Marzac/zekit/Schematics/zekit.v3.4-02.09.21-3d.png

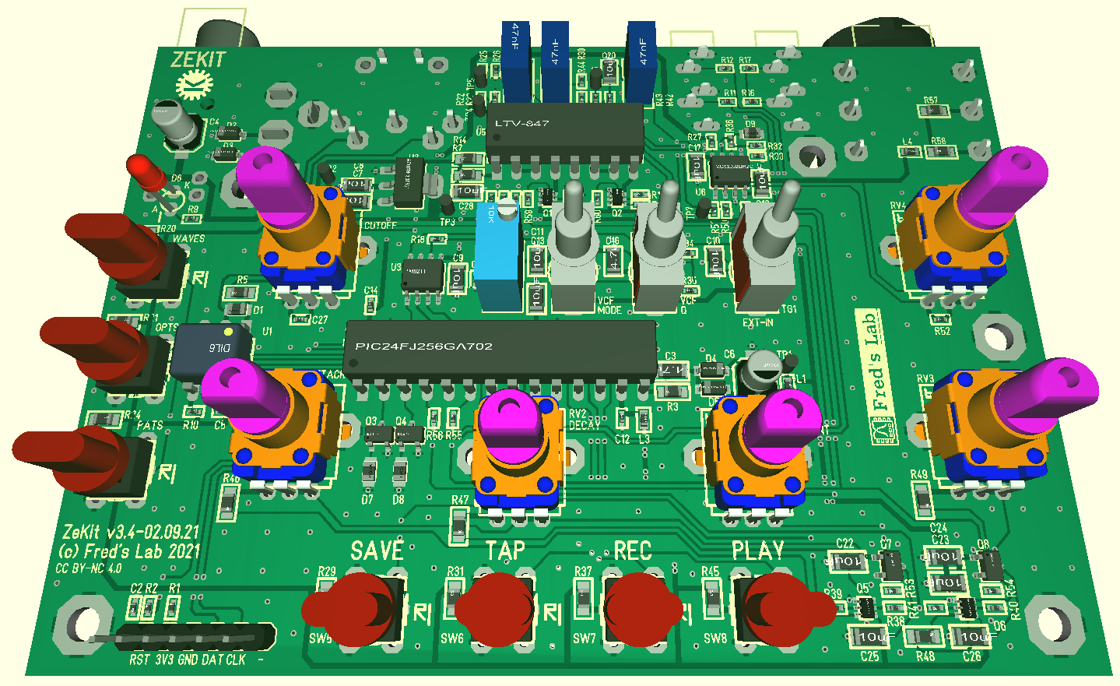
Schematics/zekit.v3.4-02.09.21-3d.png
