Marzac/zekit/Instructions/assets/signature.jpg

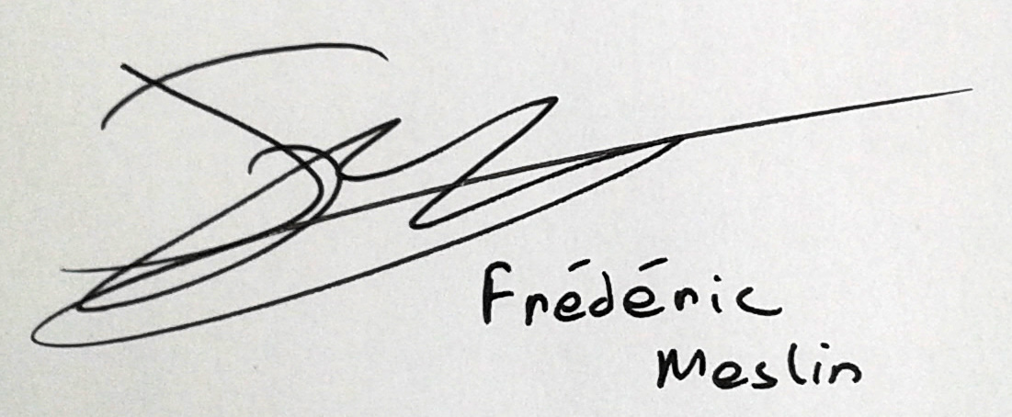
Instructions/assets/signature.jpg
