Marzac/zekit/Instructions/assets/soldering-heatup.png

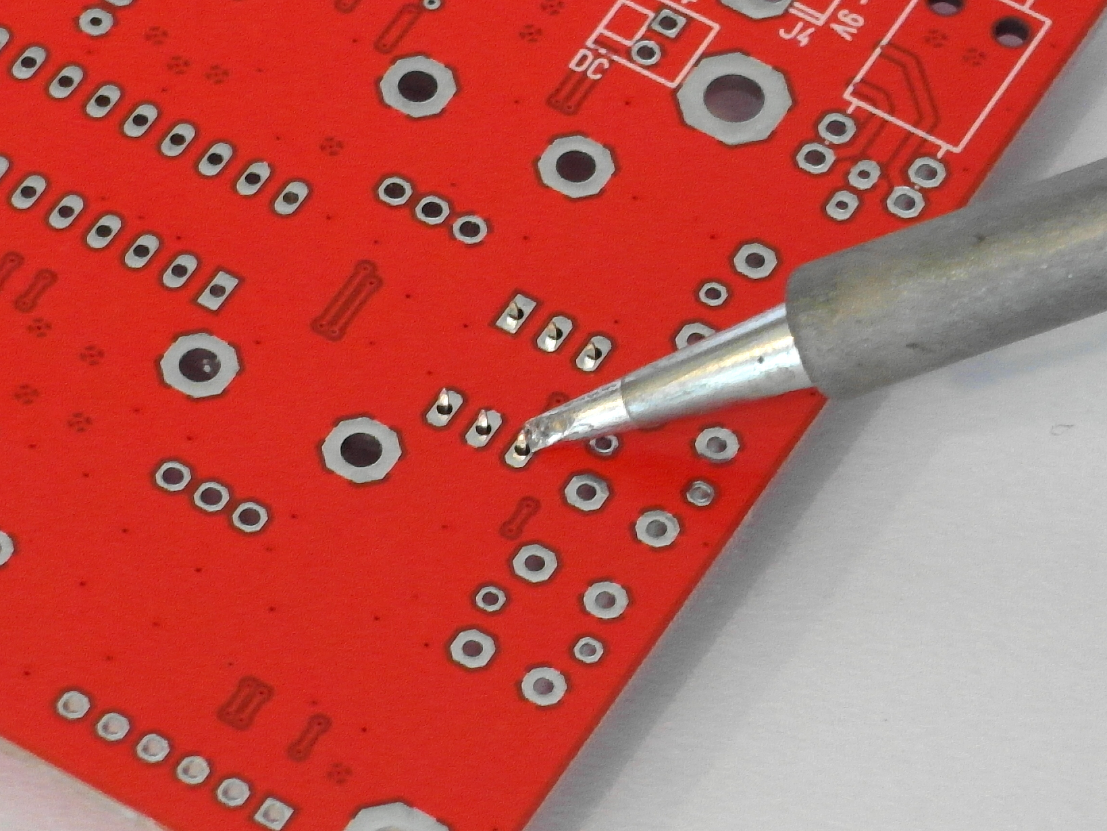
Instructions/assets/soldering-heatup.png
