Marzac/zekit/Instructions/assets/soldering-remove.png

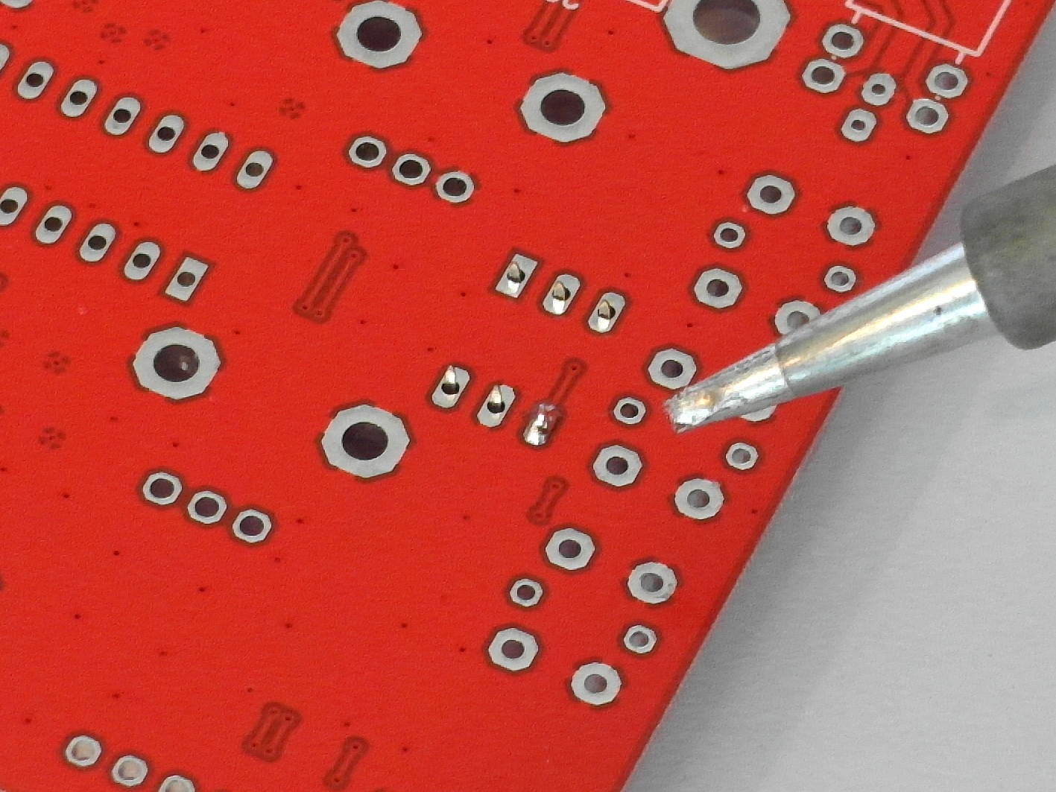
Instructions/assets/soldering-remove.png
