Marzac/zekit/Instructions/assets/soldering-solder.png

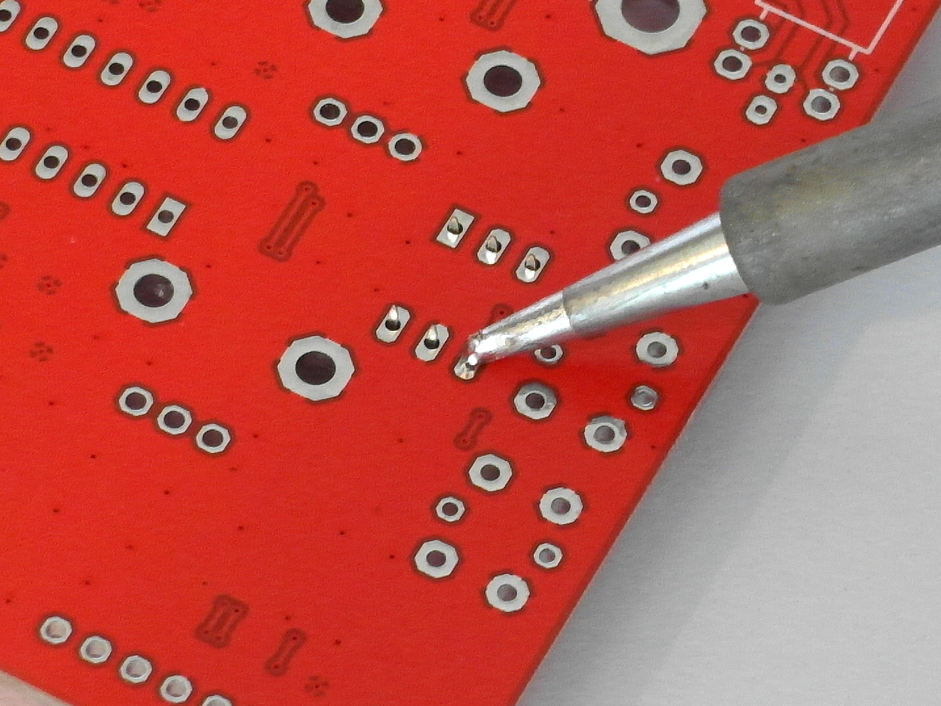
Instructions/assets/soldering-solder.png
