Marzac/zekit/Instructions/assets/soldering-tape.png

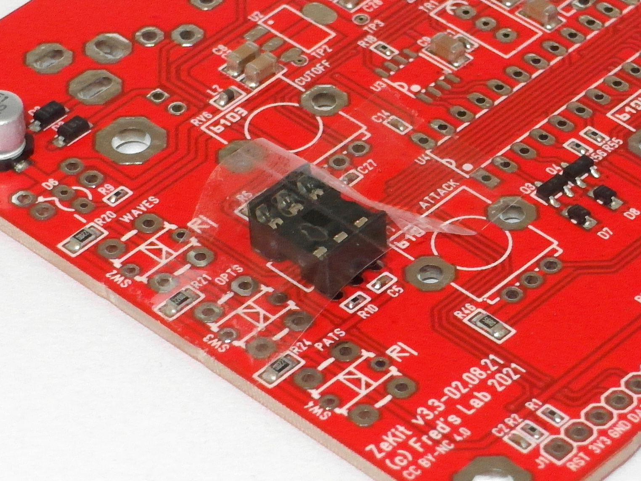
Instructions/assets/soldering-tape.png
