Marzac/zekit/Instructions/assets/soldering-wire.png

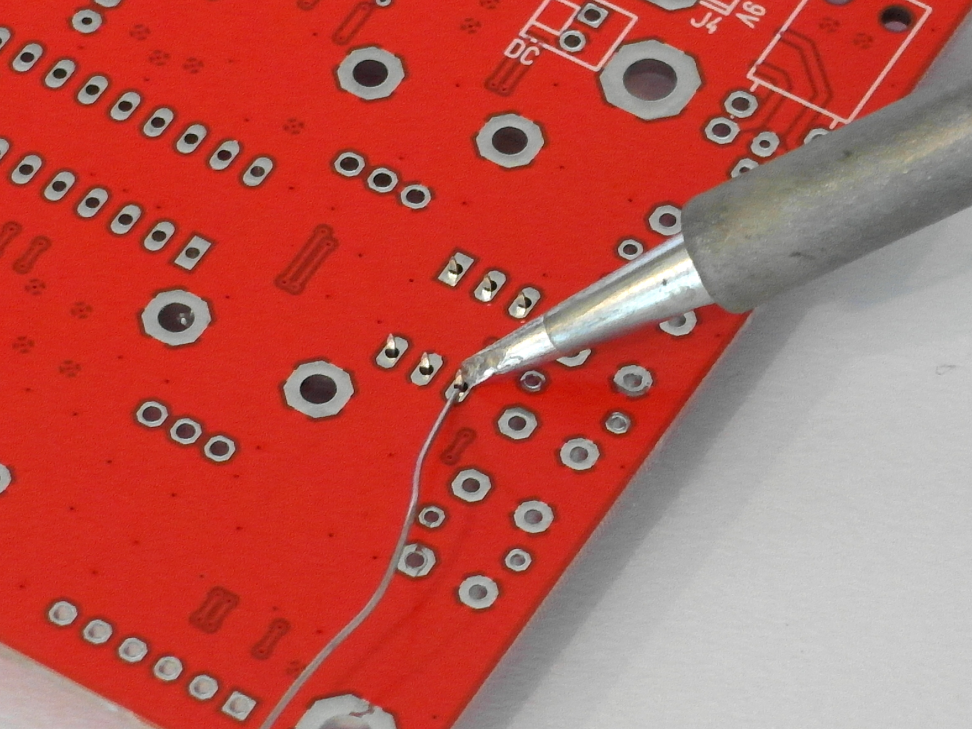
Instructions/assets/soldering-wire.png
