Marzac/zekit/Instructions/assets/weee.png

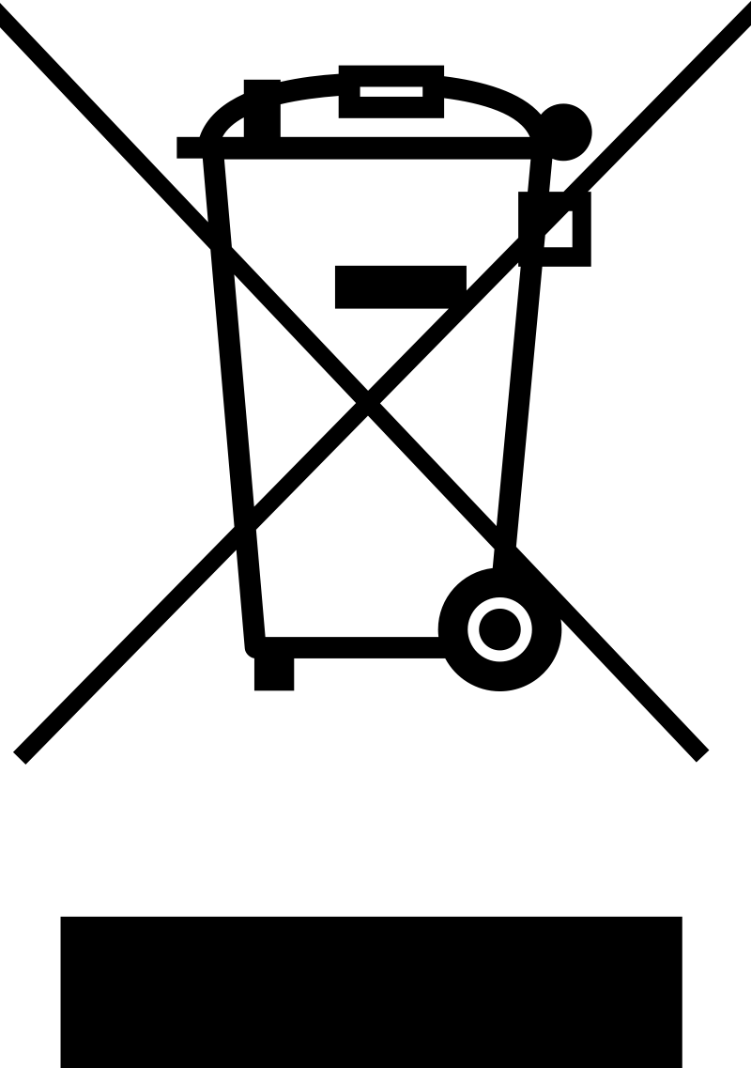
Instructions/assets/weee.png
