Marzac/zekit/Instructions/assets/zekit-assembled-back1.jpg

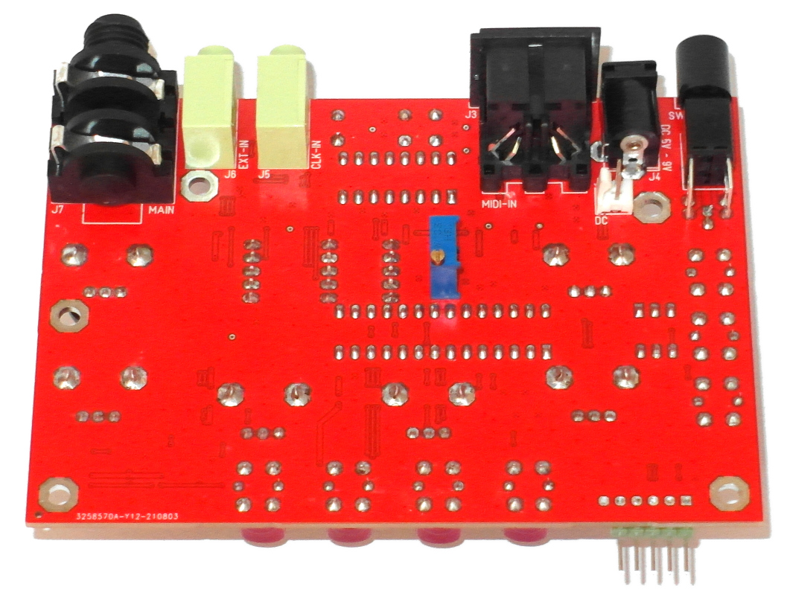
Instructions/assets/zekit-assembled-back1.jpg
