Marzac/zekit/Instructions/assets/zekit-assembled-back2.jpg

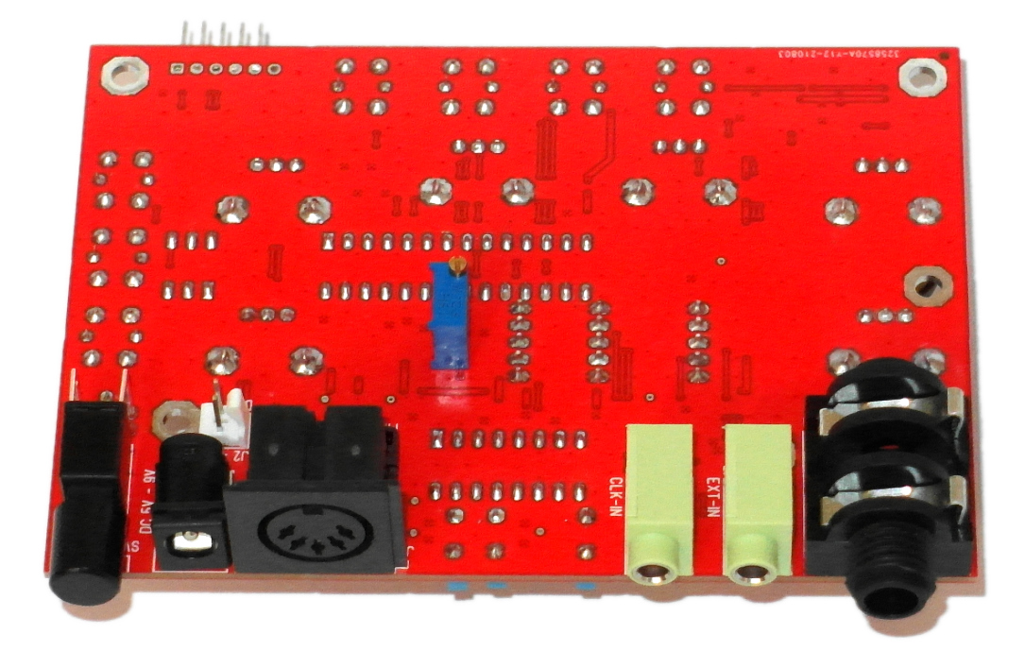
Instructions/assets/zekit-assembled-back2.jpg
