Marzac/zekit/Instructions/assets/zekit-dcjack-resized.jpg

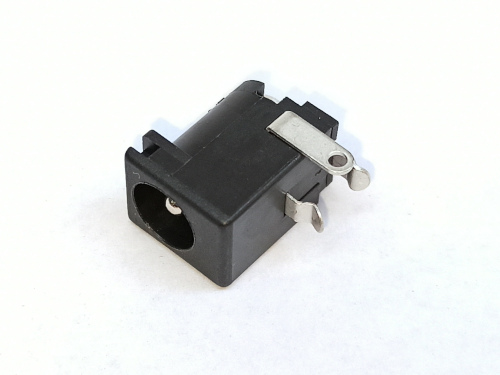
Instructions/assets/zekit-dcjack-resized.jpg
