Marzac/zekit/Instructions/assets/zekit-din-resized.jpg

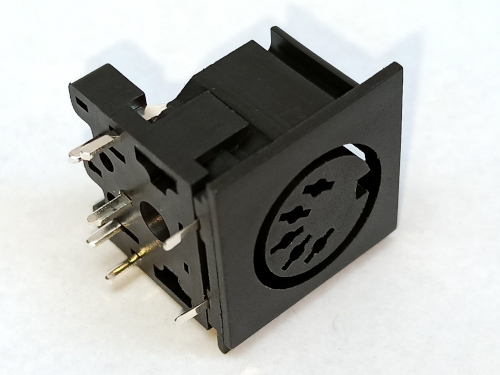
Instructions/assets/zekit-din-resized.jpg
