Marzac/zekit/Instructions/assets/zekit-filmcaps-resized.jpg

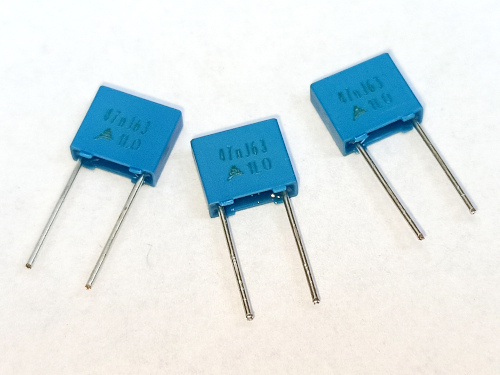
Instructions/assets/zekit-filmcaps-resized.jpg
