Marzac/zekit/Instructions/assets/zekit-jack1-resized.jpg

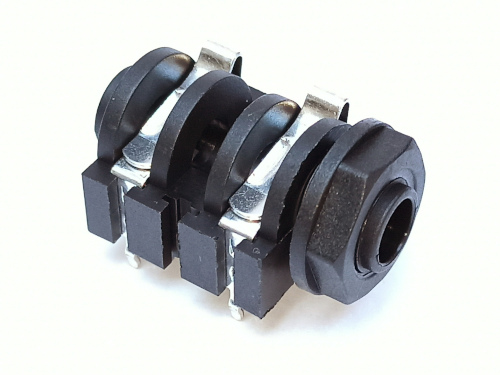
Instructions/assets/zekit-jack1-resized.jpg
