Marzac/zekit/Instructions/assets/zekit-jack2-resized.jpg

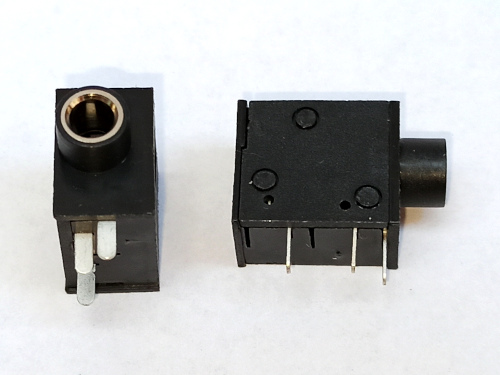
Instructions/assets/zekit-jack2-resized.jpg
