Marzac/zekit/Instructions/assets/zekit-knobs-resized.jpg

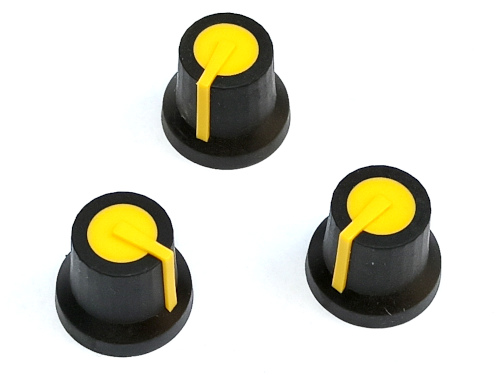
Instructions/assets/zekit-knobs-resized.jpg
