Marzac/zekit/Instructions/assets/zekit-panel.jpg

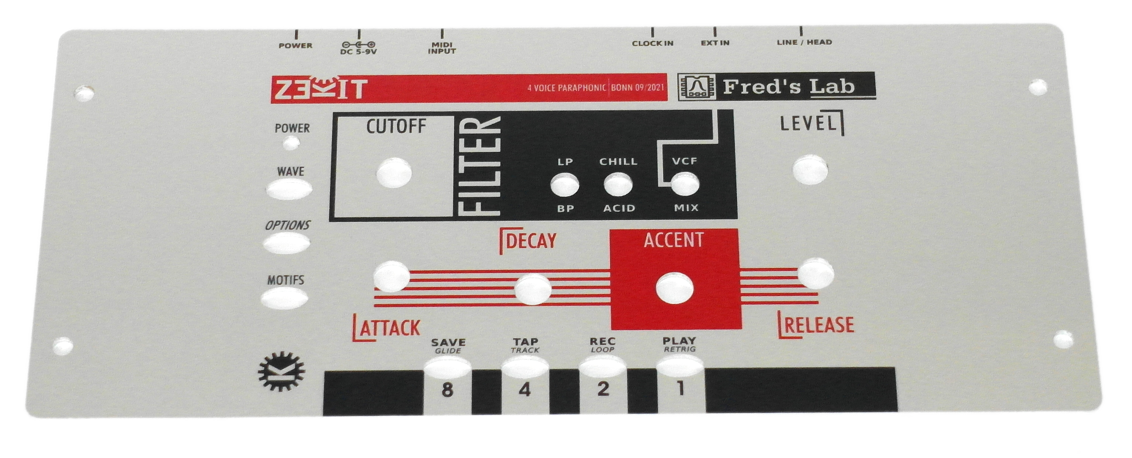
Instructions/assets/zekit-panel.jpg
