Marzac/zekit/Instructions/assets/zekit-pots1-resized.jpg

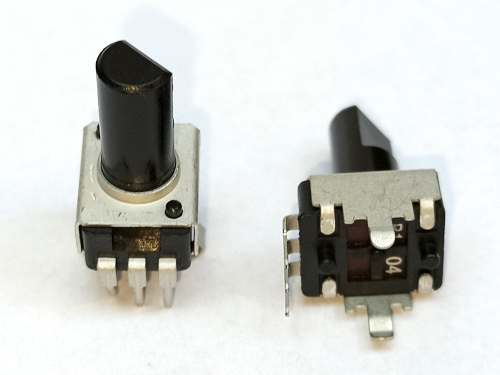
Instructions/assets/zekit-pots1-resized.jpg
