Marzac/zekit/Instructions/assets/zekit-pots2-resized.jpg

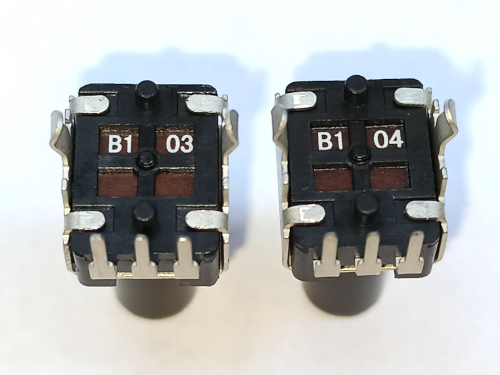
Instructions/assets/zekit-pots2-resized.jpg
