Marzac/zekit/Instructions/assets/zekit-powerswitch-resized.jpg

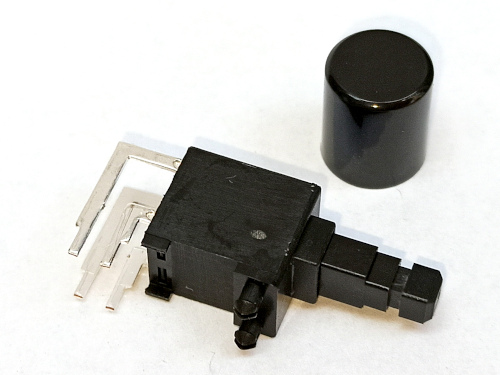
Instructions/assets/zekit-powerswitch-resized.jpg
