Marzac/zekit/Instructions/assets/zekit-sockets-resized.jpg

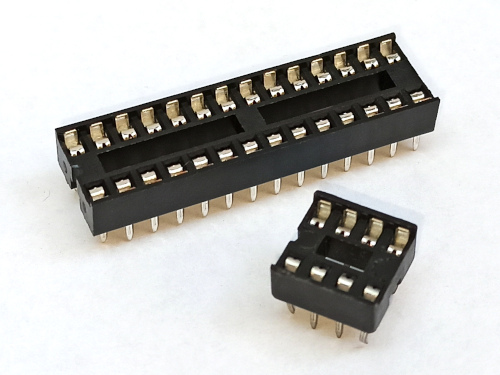
Instructions/assets/zekit-sockets-resized.jpg
