Marzac/zekit/Instructions/assets/zekit-tacts-resized.jpg

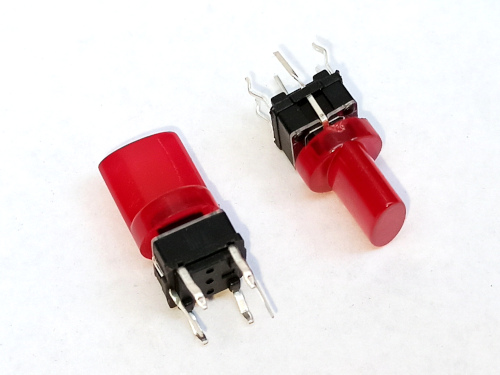
Instructions/assets/zekit-tacts-resized.jpg
