Marzac/zekit/Schematics/zekit.v3.4-02.09.21-schematics.pdf

# Schematics and tech docs LP/BP

100 R26

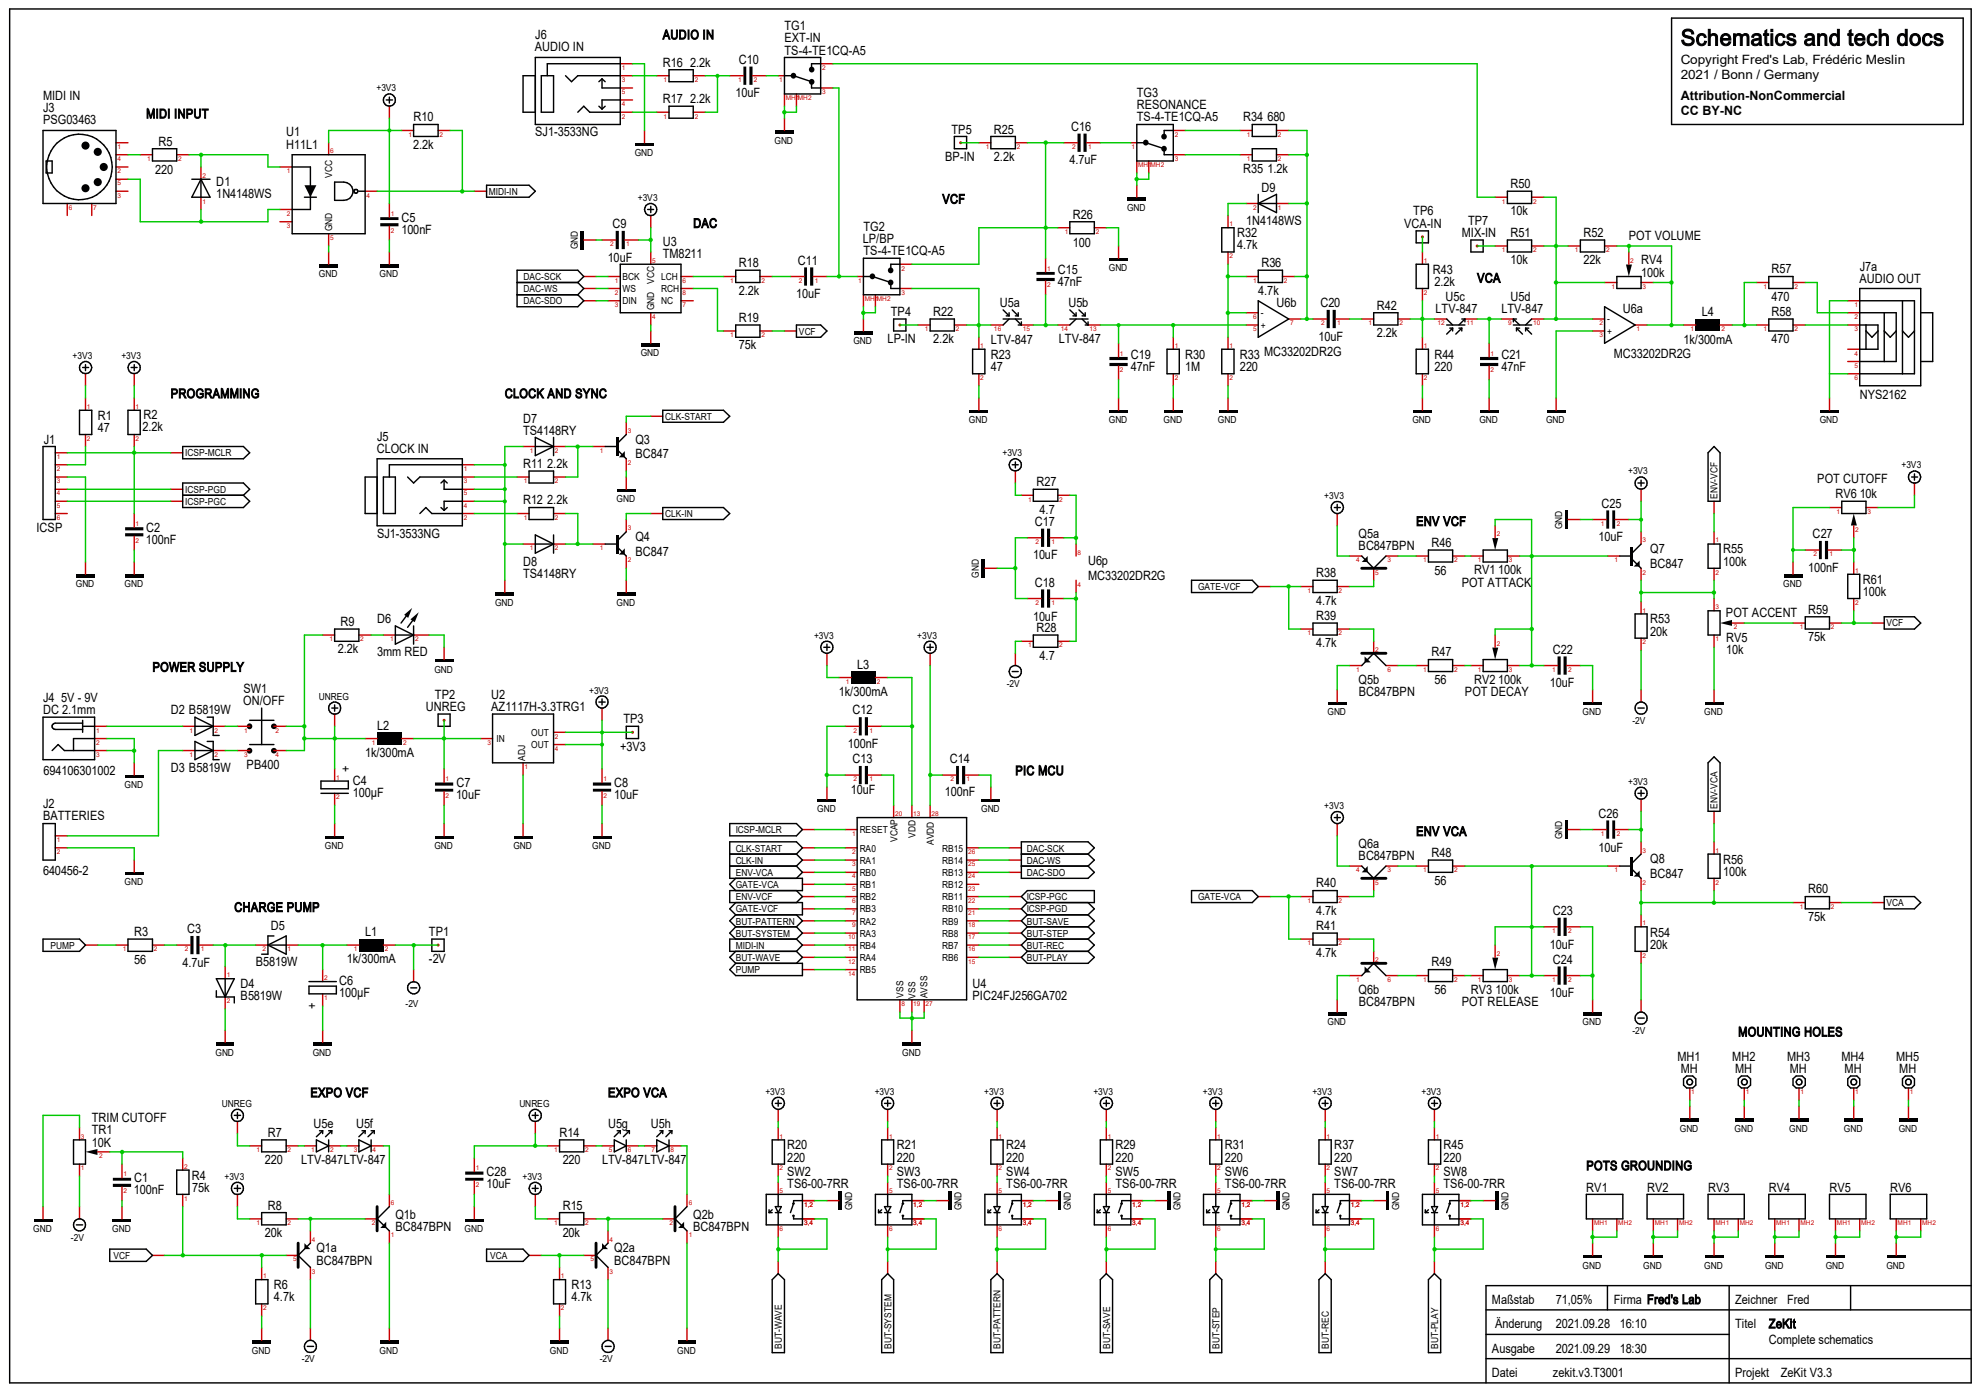
[picture p78: page 1]

Copyright Fred's Lab, Frédéric Meslin
Attribution-NonCommercial 2021 / Bonn / Germany

DAC-WS DAC-SCK

1 | ICSP-MCLR

ENV-VCF BUT-PATTERN

BUT-SYSTEM
BUT-PLAY MIDI-IN
BUT-WAVE
PUMP

Änderung 2021.09.28 16:10 | Zeichner Datei Maßstab Projekt Titel Firma ZeKit ZeKit V3.3 Fred's Lab Fred Complete schematics
