Marzac/zekit/Schematics/zekit.v3.4-02.09.21-bot.pdf

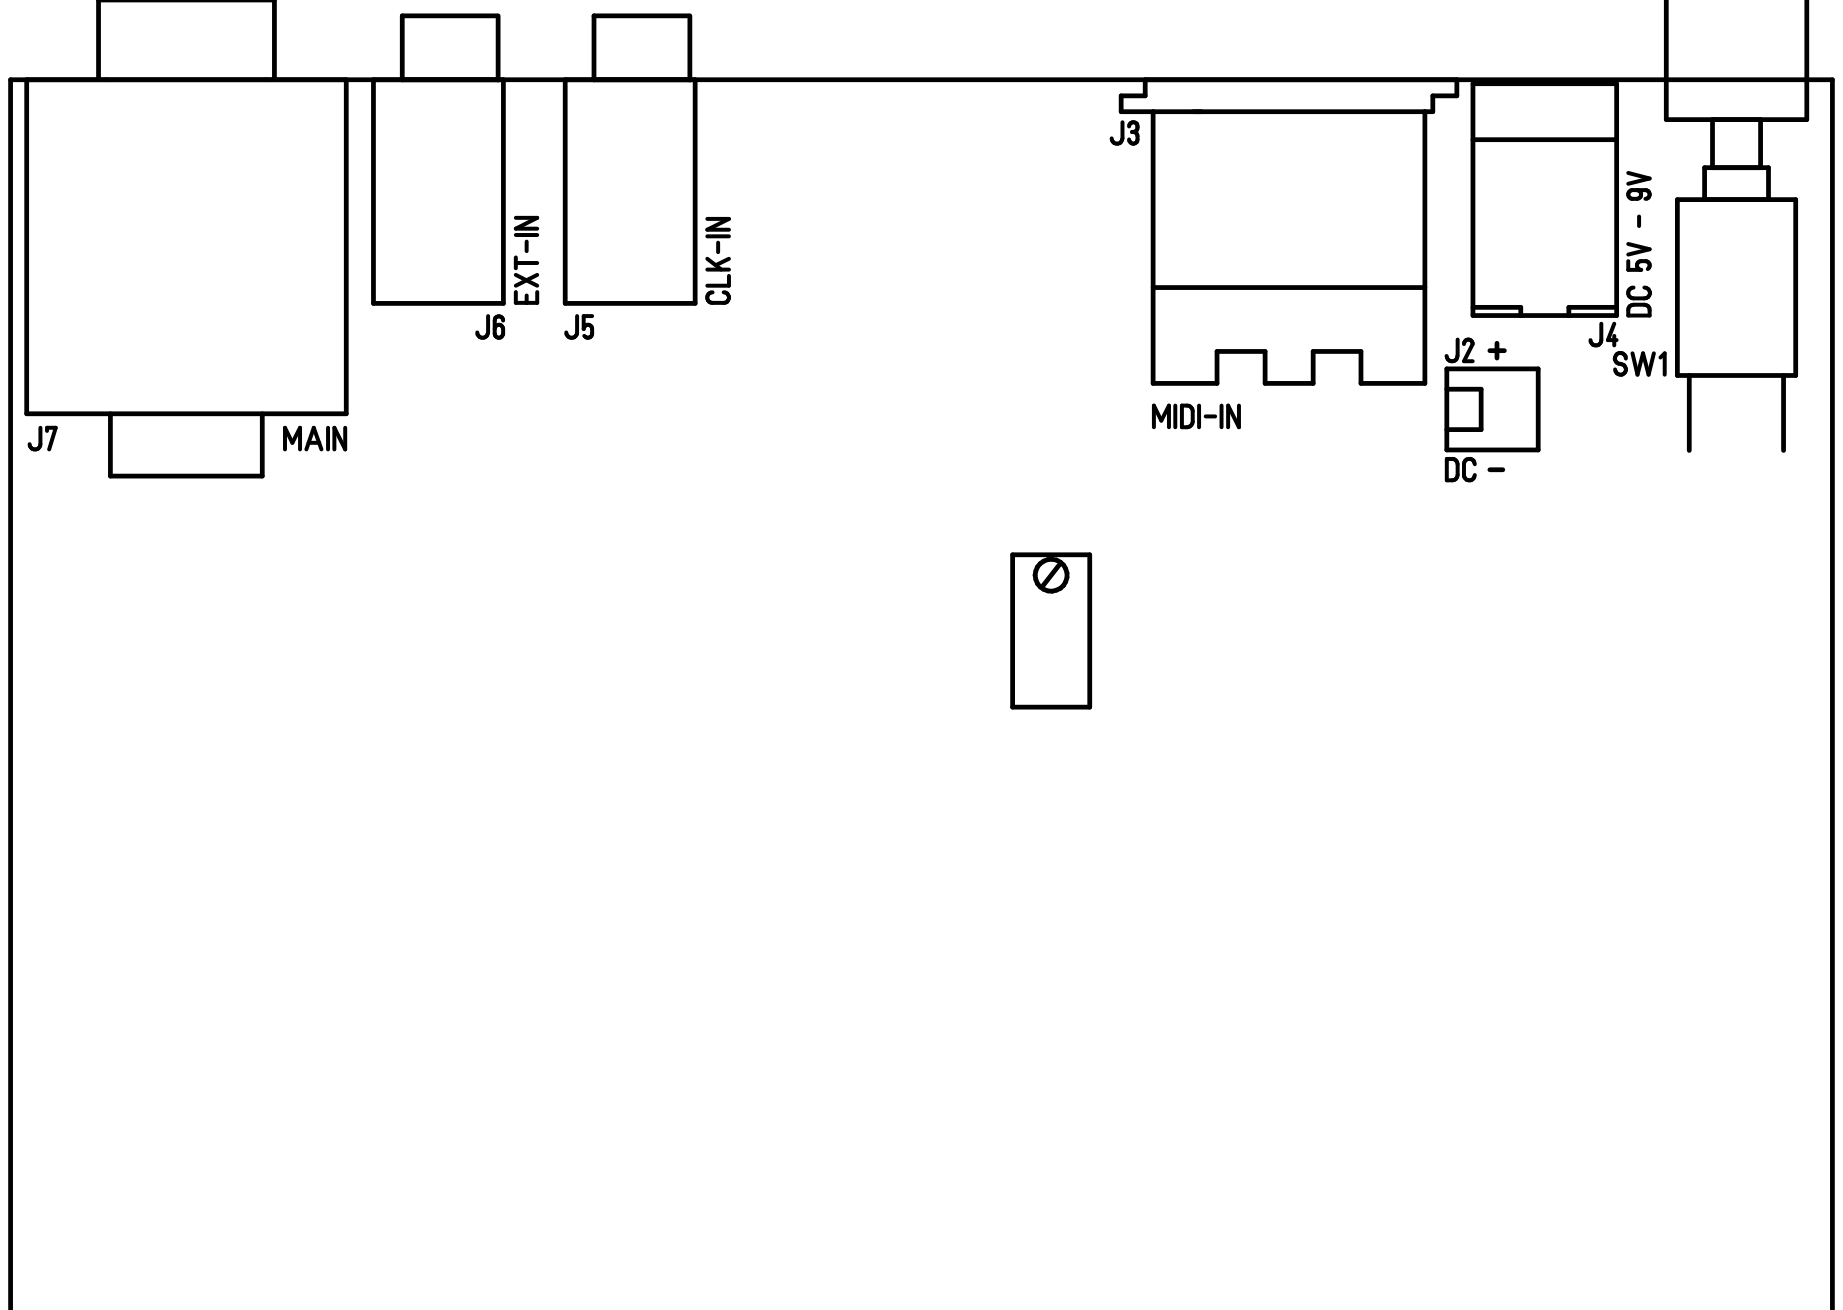
[picture p79: page 1]
