Marzac/zekit/Schematics/zekit.v3.4-02.09.21-top.pdf

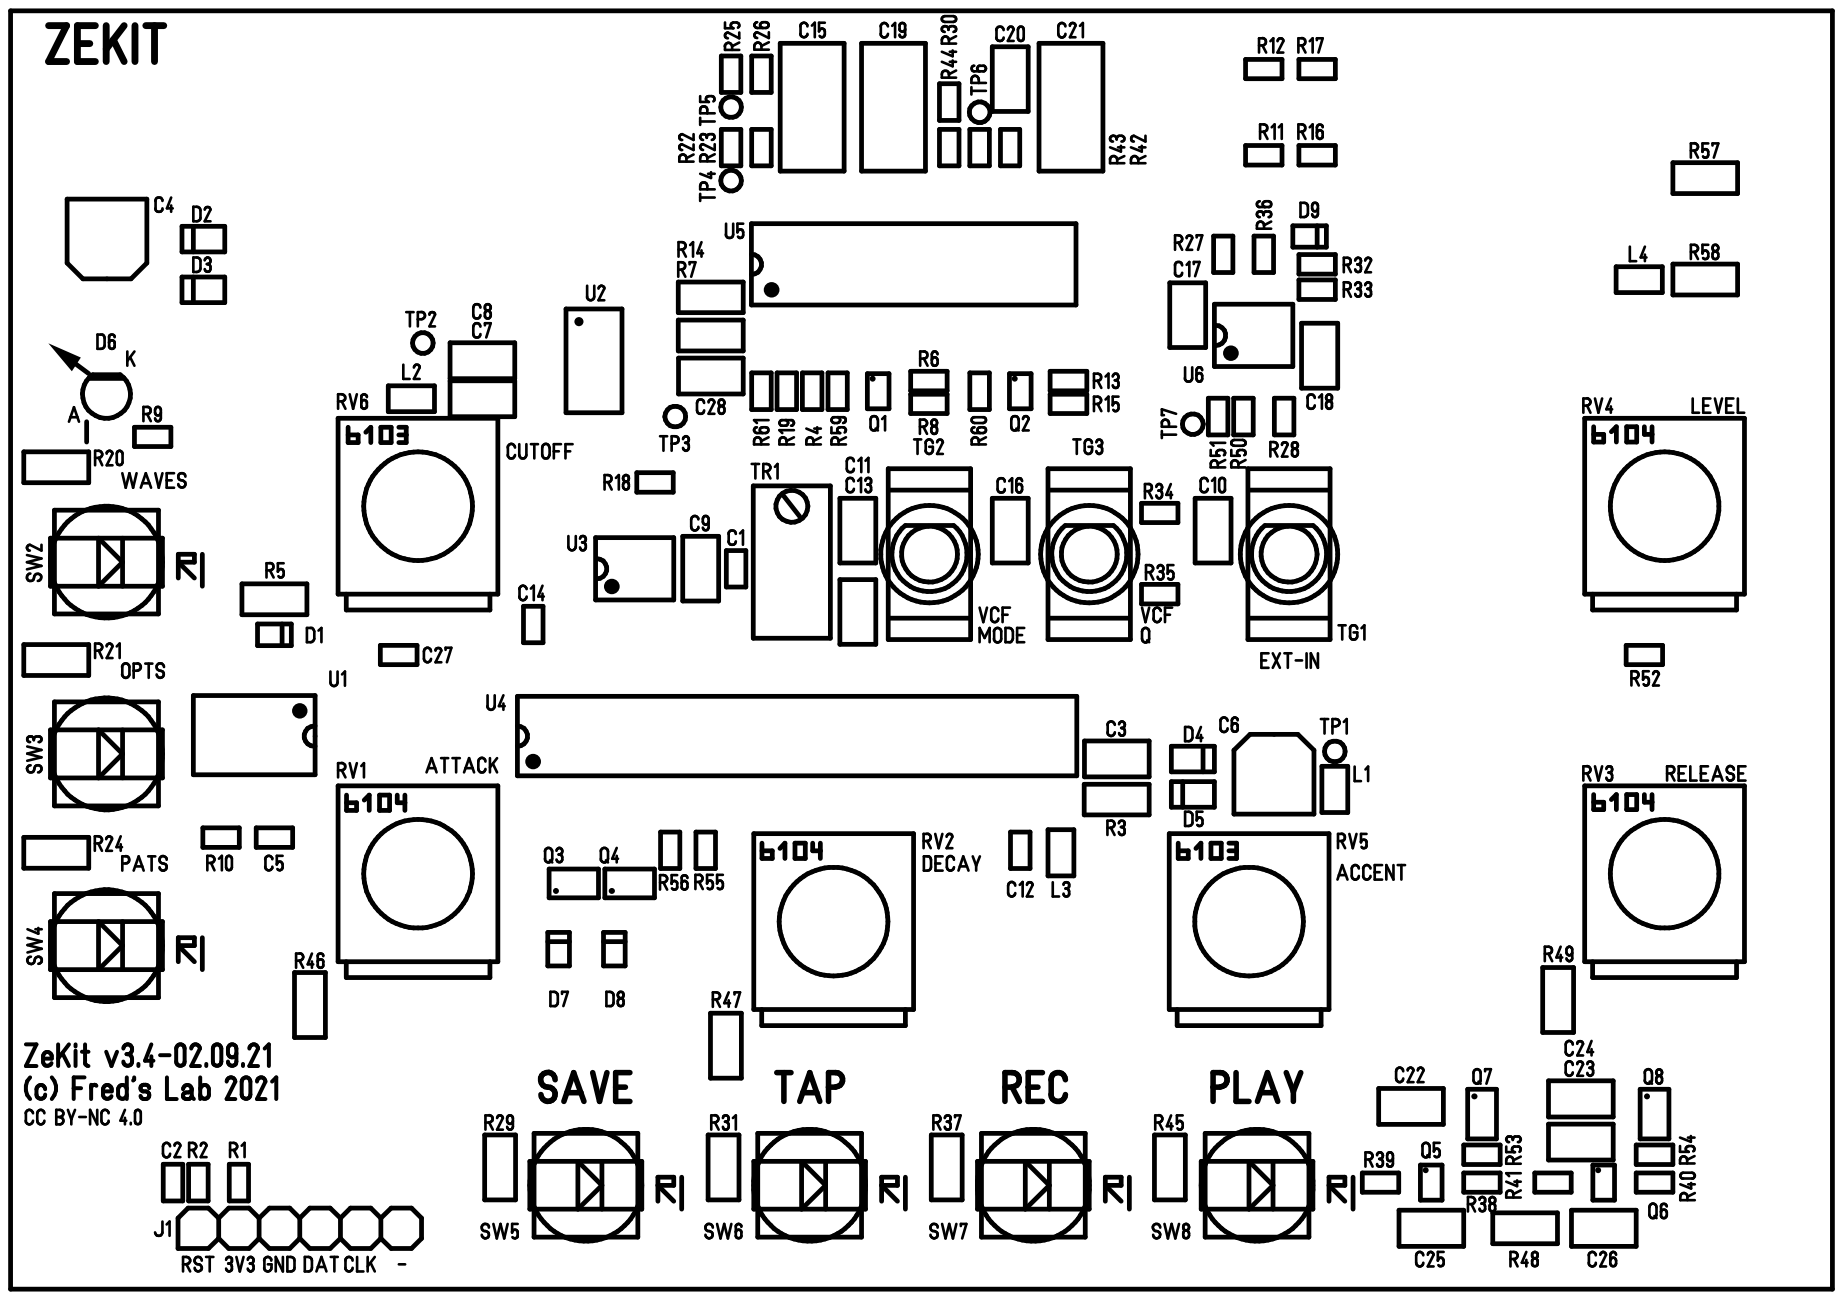
[picture p80: page 1]
