Marzac/zekit/Firmware/main.c

/**
 * ZeKit Firmware v2.0
 * Copyright (C) 2021/2022 - Frédéric Meslin
 * Contact: fred@fredslab.net

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
 * You should have received a copy of the GNU General Public License
 * along with this program.	 If not, see <https://www.gnu.org/licenses/>.
 */
/******************************************************************************/

#include "setup.h"
#include "midi.h"
#include "mseq.h"
#include "audio.h"
#include "store.h"
#include "ui.h"

#include "pins.h"
#include "config.h"

#include <xc.h>
#include <stdint.h>

/******************************************************************************/
uint16_t uwTick = 0;

/******************************************************************************/
int main(void)
{
// Peripherals setup
	setup();

// Program initialisation
	midiInit();
	audioInit();
	mseqInit();
	uiInit();

// Program main loop
	while (1) {
		uiUpdate();
		midiUpdate();
		mseqUpdate();
		audioUpdate();
	}

	return 1;
}
