Marzac/zekit/Firmware/waves.c

/**
 * ZeKit Firmware v2.0
 * Copyright (C) 2021/2022 - Frédéric Meslin
 * Contact: fred@fredslab.net

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
 * You should have received a copy of the GNU General Public License
 * along with this program.	 If not, see <https://www.gnu.org/licenses/>.
 */
/******************************************************************************/

#include "waves.h"

#include <stdint.h>

/******************************************************************************/
const Sawer wavesMono[MAX_WAVES][4] = {
{
// Basic sawtooth
	{.phase = 0x00000000, .rate = 128, .shift = 1},
	{.phase = 0x00000000, .rate = 0,   .shift = 16},
	{.phase = 0x00000000, .rate = 0,   .shift = 16},
	{.phase = 0x00000000, .rate = 0,   .shift = 16}},

// Detuned sawtooth
{
	{.phase = 0x00000000, .rate = 127, .shift = 2},
	{.phase = 0x00000000, .rate = 129, .shift = 2},
	{.phase = 0x00000000, .rate = 128, .shift = 2},
	{.phase = 0x00000000, .rate = 0,   .shift = 16}},

// Basic square
{
	{.phase = 0x00000000, .rate = 128, .shift = 2},
	{.phase = 0x80000000, .rate =-128, .shift = 2},
	{.phase = 0x00000000, .rate =	0, .shift = 16},
	{.phase = 0x00000000, .rate =	0, .shift = 16}},

// Detuned square
{
	{.phase = 0x00000000, .rate = 127, .shift = 2},
	{.phase = 0x80000000, .rate =-127, .shift = 2},
	{.phase = 0x00000000, .rate = 129, .shift = 2},
	{.phase = 0x80000000, .rate =-129, .shift = 2}},

// Pulse 25%
{
	{.phase = 0x00000000, .rate = 128, .shift = 1},
	{.phase = 0x40000000, .rate =-128, .shift = 1},
	{.phase = 0x00000000, .rate =	0, .shift = 16},
	{.phase = 0x00000000, .rate =	0, .shift = 16}},

// Double-sawtooth
{
	{.phase = 0x00000000, .rate = 128, .shift = 1},
	{.phase = 0x00000000, .rate = 256, .shift = 2},
	{.phase = 0x00000000, .rate =	0, .shift = 16},
	{.phase = 0x00000000, .rate =	0, .shift = 16}},

// Pulse 10%
{
	{.phase = 0x00000000, .rate = 128, .shift = 1},
	{.phase = 0x18000000, .rate =-128, .shift = 1},
	{.phase = 0x00000000, .rate =	0, .shift = 16},
	{.phase = 0x00000000, .rate =	0, .shift = 16}},

// Ultrasaw
{
	{.phase = 0x00000000, .rate = 127, .shift = 2},
	{.phase = 0x00000000, .rate = 130, .shift = 2},
	{.phase = 0x00000000, .rate = 128, .shift = 2},
	{.phase = 0x80000000, .rate = 256, .shift = 2}},
};

/******************************************************************************/
const Sawer wavesPara[MAX_WAVES][2] = {
{
// Basic sawtooth
	{.phase = 0x00000000, .rate = 128, .shift = 3},
	{.phase = 0x00000000, .rate =	0, .shift = 16}},

// Detuned sawtooth 1
{
	{.phase = 0x00000000, .rate = 255, .shift = 3},
	{.phase = 0x80000000, .rate = 257, .shift = 3}},

// Basic square
{
	{.phase = 0x00000000, .rate = 128, .shift = 4},
	{.phase = 0x80000000, .rate =-128, .shift = 4}},

// Double sawtooth
{
	{.phase = 0x00000000, .rate = 128, .shift = 3},
	{.phase = 0x80000000, .rate = 64,  .shift = 4}},

// Pulse 25%
{
	{.phase = 0x00000000, .rate = 128, .shift = 3},
	{.phase = 0x40000000, .rate =-128, .shift = 3}},

// Detuned sawtooth 2
{
	{.phase = 0x00000000, .rate = 256, .shift = 3},
	{.phase = 0x80000000, .rate = 127, .shift = 4}},

// Pulse 10%
{
	{.phase = 0x00000000, .rate = 128, .shift = 3},
	{.phase = 0x18000000, .rate =-128, .shift = 3}},

// Detuned sawtooth 2
{
	{.phase = 0x00000000, .rate = 129, .shift = 3},
	{.phase = 0x80000000, .rate = 127, .shift = 3}},
};
