Marzac/zekit/(commit log)

2021-05-13 Missing tact switch picture
2021-05-14 Guide: initial setup with common parts and schematics
2021-05-16 Guide: linear regulator
2021-05-16 Guide: linear regulator with less text by Fred
2021-05-16 Guide: charge pump
2021-05-16 Guide: charge pump fix
2021-05-17 Guide: MCU, DAC, tactile switches
2021-05-18 Guide: envelopes, MIDI input, clock input, exponential control circuit
2021-05-18 Guide: exponential control circuit
2021-05-20 Guide: switches, jacks, optocouplers
2021-05-21 Guide: soldering order with remarks
2021-05-31 Guide: trimmers labeling, power switch placement, intro text additions
2021-08-23 New schematics parts
2021-08-23 Integration of schematics in manual
2021-08-23 Correcting VCA schematics
2021-08-27 Complete assembly manual, for review
2021-08-30 Assembly manual corrections
2021-08-30 Version 1.1 of the assembly manual
2021-09-29 Schematics + board diagrams
2021-12-01 Fixing glitch in envelope triggering, adding sequencer tie, fixing tuning storing, cleaning up
    [audio.c, interrupts.c, mseq.c, ui.c, ui.h, waves.h]
